TALs-Education/NanoBalancer/README.md

# NanoBalancer
Nano Balancer Robot, based on Arduino nano esp32, Arduino nano motor shield
