TALs-Education/NanoBalancer/NanoBalancer BOM - NanoBalancer BOM V02.pdf

NanoBalancer BOM V02 | https://a360.co/4zzZkpO
Parts | Units | Price [nis] | Total 10 for units Link | Comments | Link2
M3x6 | 4 | 0.8 | 40 https://www.4project.co.il/product/screw-m3x6mm-galvanized 4 Arduino mkr motor shield bolts
M3 plastic disc | 4 | 0.1 | 40 https://www.4project.co.il/product/washer-m3-nylon spacer to protect circuit
M3x10 | 10 | 4.563 | 100 https://www.digikey.co.il/he/products/detail/io-audio-technologies/IO-M3X10-M3HN-100/13949728 V shape bolts: 2 - battery holder 6 bumper holders, spare
M4x20 | 2 | 1.904 | 20 https://www.4project.co.il/product/screw-m4x20mm-button-head-25pack Beam Bolts
XT30 Female | 1 | 6.3 | 10 https://www.4project.co.il/product/181184 XT30 Safe Plug
Micro usb cable | 1 | 25.8 | 10 https://www.4project.co.il/product/microb-usb-cable-1.8m micro usb to usb cable for arduino
ABX00041 Motor carrier | 1 | 362.15 | 10 https://www.digikey.co.il/en/products/detail/arduino/ABX00041/16645360 arduino nano33 iot motor carrier
Arduino Nano ESP32 | 1 | 105.2 | 10 https://www.4project.co.il/product/arduino-nano-esp32 arduino nano33 ESP32
18650 battery holder | 1 | 5.2 | 10 https://www.4project.co.il/product/1x18650-battery-holder battery holder 18650
Li-Ion 3.7V/2500mAh | 1 | 34.7 | 10 https://www.4project.co.il/product/18650-lg-he4-battery-3.7v-2500mah 18650 battery
3d Printer filament | 0.2 | 34.45 | 2 https://www.4project.co.il/product/petg-1.75mm-red-filament Petg 3d filament blue red green
3d Printer filament flexible | 0.2 | 24.38 | 2 https://www.4project.co.il/product/tpu-flex-1.75mm-red-filament flex filament for bumpers
micro motor 1:30 hpcb 12v | 2 | 121.9 | 20 https://www.4project.co.il/product/micro-metal-gearmotor-hpcb-12v-1100rpm-encoder-shaft 4P-6977 / POL-3049
Micro motor extended holder | 1 | 25.8 | 10 https://www.4project.co.il/product/micro-motor-holder-extended-white 4P-504 / POL-1089
magnetic encoder | 1 | 37.3 | 10 https://www.4project.co.il/product/207352 4P-207352 / POL-4761
jst-sh encoder wires | 2 | 5.6 | 20 https://www.4project.co.il/product/6pin-female-jst-sh-style-cable-12cm 4P-207349 / POL-4762
wheels 40mm | 1 | 25.8 | 10 https://www.4project.co.il/product/4823 4P-4823 / POL-1453

## Optional - Maybe required

lithium charger | 1 | 57.4 | 10 https://www.4project.co.il/product/sparkfun-lipo-charger-plus 4P-395500 / SF-PRT-15217
xt30 charger wires | 1 | 11.4 | 10 https://www.4project.co.il/product/xt30-female-awg16-300mm 4P-560542 / SC-3800-0002-0300
JST-PH 2-pin | 1 | 3.9 | 10 https://www.4project.co.il/product/jst-ph-2pin-connector-with-wires battery connector
usb C cable | 1 | 31.9 | 10 https://www.4project.co.il/product/usb-c-cable-90cm Battery charger wire
USB meter | 1 | 48.9 | 10 https://www.4project.co.il/product/848782 USB voltage current meter
| Total Price | 975.447 | 9754.47
