TALs-Education/NanoBalancer/NanoBalancer_Stabilization_Parameters.xlsx

Sheet: Summary
NanoBalancer — Stabilisation Parameters Summary
All values are live formulas linked to Inputs (edit blue cells there). Model state: d276 = 8 mm, sliced print masses, 2× 18650 in parallel.
Parameter | Symbol / key | Value | Unit | Source / formula notes
Mass & geometry
Total mass | S_M | 426.4 | g
Body mass (excl. wheels) | S_mb | 420.0 | g
Body CoM height above axle l | S_l | 135.3 | mm
CoM fore/aft offset from axle | S_z | -0.004 | mm | ≈ 0 → balance point is vertical
Wheel radius | S_r | 20.0 | mm
Wheel track | S_track | 84.3 | mm
Moments of inertia
Body pitch inertia about axle | S_Ibax | 107315.1525 | g·cm²
Body pitch inertia about CoM | S_Ib | 30458.9594 | g·cm²
Wheel-side inertia (2 wheels + reflected rotors) | S_Iw | 69.8 | g·cm² | Rotor part is an ASSUMPTION
Yaw inertia | S_Iyaw | 3832.822522 | g·cm²
Motor & driver
Max torque per motor (500 mA limit) | S_Tlim | 0.244 | kg·cm
Max total torque | S_Ttot | 48.0 | mN·m
Fraction of motor stall torque usable | S_Tfrac | 62.68656716% | –
Max ground speed (no load) | S_vmax | 2.30 | m/s
Full torque available up to | S_vcorner | 0.86 | m/s
Balancing
Unstable open-loop pole (wheels free) | S_p | 12.69 | rad/s
Fall time constant | S_tfall | 78.77685906 | ms
Recommended min. control-loop rate | S_floop | 100 | Hz
Torque authority τ_max / (m_b·g·l) | S_ratio | 0.086 | –
Max tilt holdable with wheels blocked | S_hold | 4.9 | deg
Max recoverable lean (small-angle, at low speed) | S_thss | 36.5 | deg
Max steady acceleration | S_acc | 5.40 | m/s²
Power
Peak battery current (both motors at limit) | S_Ibat | 4.12 | A
Estimated runtime | S_run | 5.9 | h | ASSUMED average power

Sheet: Inputs
NanoBalancer — Inputs (blue = editable input)
Parameter | Symbol / key | Value | Unit | Source / formula notes
Physical constants
Gravity | g | 9.81 | m/s² | Standard gravity
Whole robot (from Fusion 360, wheels included)
Total mass | M_tot | 0.4264 | kg | Fusion 360 physical properties (VeryHigh accuracy), file NanoBalancer_V01 v3, d276 = 8 mm, sliced print masses
CoM height above axle (Y) | y_com_tot | 0.13324 | m | Fusion 360 physical properties (VeryHigh accuracy), file NanoBalancer_V01 v3, d276 = 8 mm, sliced print masses. Axle is the world X axis (y = 0, z = 0).
CoM fore/aft offset from axle (Z) | z_com_tot | -0.000004 | m | Fusion 360 physical properties (VeryHigh accuracy), file NanoBalancer_V01 v3, d276 = 8 mm, sliced print masses. Tuned to ~0 by d276 = 8 mm.
Ixx about axle (pitch), whole robot | Ixx_tot | 0.01073314845 | kg·m² | Fusion 360 physical properties (VeryHigh accuracy), file NanoBalancer_V01 v3, d276 = 8 mm, sliced print masses. Moments are about the world origin, which lies on the axle.
Iyy about vertical axis through axle centre (yaw) | Iyy_tot | 0.0003832822522 | kg·m² | Fusion 360 physical properties (VeryHigh accuracy), file NanoBalancer_V01 v3, d276 = 8 mm, sliced print masses
Izz about fore/aft axis (roll) | Izz_tot | 0.0108836442 | kg·m² | Fusion 360 physical properties (VeryHigh accuracy), file NanoBalancer_V01 v3, d276 = 8 mm, sliced print masses
Wheels (Pololu 40x7 mm, per wheel, from Fusion 360)
Wheel mass (each) | m_w1 | 0.00320 | kg | Fusion 360 physical properties (VeryHigh accuracy), file NanoBalancer_V01 v3, d276 = 8 mm, sliced print masses. Datasheet-based 3.2 g assigned.
Wheel spin inertia about axle (each) | Iw_spin1 | 8.166023149e-07 | kg·m² | Fusion 360 physical properties (VeryHigh accuracy), file NanoBalancer_V01 v3, d276 = 8 mm, sliced print masses (Ixx of wheel body).
Wheel radius | r_w | 0.020 | m | Pololu 40 mm wheel (model bbox 40.0 mm).
Wheel track (centre to centre) | track | 0.0843 | m | Fusion 360 physical properties (VeryHigh accuracy), file NanoBalancer_V01 v3, d276 = 8 mm, sliced print masses (wheel centroids).
Gearmotor: Pololu #3049, 30:1 Micro Metal Gearmotor HPCB 12 V, extended shaft (per motor)
Rated / spec voltage | V_rated | 12.0 | V | Pololu #3049 specs.
Gear ratio | N | 29.86 | – | Pololu #3049 specs (29.86:1).
No-load speed @ 12 V (output) | rpm_nl | 1100 | rpm | Pololu #3049 specs (typ. ±20%).
No-load current @ 12 V | I_nl | 0.080 | A | Pololu #3049 specs (typ. ±50%).
Stall current @ 12 V | I_stall | 0.750 | A | Pololu #3049 specs (theoretical extrapolation).
Stall torque @ 12 V (output) | T_stall_kgcm | 0.39 | kg·cm | Pololu #3049 specs (theoretical extrapolation).
Motor rotor inertia (motor side) — ASSUMPTION | J_rotor | 3e-09 | kg·m² | ASSUMPTION: ~0.03 g·cm², typical for 10 mm coreless/brushed micro motors. Not published by Pololu. Reflected to the wheel ×N² — verify by spin-down test.
Motor driver: Arduino Nano Motor Carrier ABX00041 (4× MP6522)
Motor driver output voltage (boosted) | V_drv | 12.0 | V | ABX00041 datasheet: motor driver output voltage 12 V.
Max output current per motor driver | I_lim | 0.500 | A | ABX00041 datasheet: 500 mA per driver. MP6522 chip itself is 3.2 A peak; board limit governs.
Max battery input (power terminals) | V_bat_max | 4.0 | V | ABX00041 datasheet: max 4 V (1S Li-ion).
Boost converter efficiency — ASSUMPTION | eta_boost | 85% | – | ASSUMPTION: typical small boost converter 3.7→12 V.
Battery: 2× LG HE4 18650 in parallel (1S2P)
Cells in parallel | n_cells | 2 | – | Model has two holders; carrier accepts 1S only → parallel.
Cell nominal voltage | V_cell | 3.60 | V | LG HE4 nominal 3.6 V.
Cell capacity | C_cell | 2.50 | Ah | BOM: Li-Ion 3.7V/2500mAh (LG HE4).
Cell max continuous discharge | I_cell_max | 20 | A | LG HE4 datasheet: 20 A continuous.
Electronics power (ESP32 + carrier + IMU) — ASSUMPTION | P_elec | 0.60 | W | ASSUMPTION: Nano ESP32 with WiFi idle ~0.4 W + carrier/IMU ~0.2 W.
Average motor electrical power while balancing — ASSUMPTION | P_mot_avg | 2.00 | W | ASSUMPTION for runtime estimate; measure with the USB meter / current sense.
Sensor location
IMU (BNO055 on carrier) height above axle — APPROX. | y_imu | 0.0625 | m | Carrier centre from rough model (exact chip position on PCB not modelled).
Control design guidance
Loop-rate multiple of unstable pole frequency | k_loop | 30 | – | Rule of thumb: sample ≥ 20–40× the open-loop unstable pole frequency.
Legend: blue = hard-coded input (edit here) · black = formula · green = link from another sheet · yellow fill = key / uncertain inputs worth checking.

Sheet: Inertia
Mass & Moment of Inertia
Parameter | Symbol / key | Value | Unit | Source / formula notes
Wheel side (both wheels + reflected rotor)
Mass of both wheels | m_w | 0.00640 | kg | 2 × wheel mass
Spin inertia, both wheels | Iw_wheels | 1.63320463e-06 | kg·m² | 2 × wheel Ixx
Reflected rotor inertia, both motors | Iw_rotor | 5.3497176e-06 | kg·m² | J_rotor × N² × 2 (ASSUMED rotor inertia)
Total wheel-side inertia Iw | Iw | 6.98292223e-06 | kg·m² | Used in dynamics
Body (everything except wheels; motor stators/gearboxes are part of body)
Body mass m_b | m_b | 0.4200 | kg | Total − wheels
Body CoM height above axle l | l | 0.13527 | m | Wheels' CoM lies on axle → l = M·y / m_b
Body CoM fore/aft offset | z_b | -0.000004 | m
Body pitch inertia about axle | Ib_axle | 0.01073151525 | kg·m² | Ixx(total) − wheel Ixx (wheels are on the axle)
Body pitch inertia about own CoM Ib | Ib | 0.00304589594 | kg·m² | Parallel-axis theorem
Body radius of gyration about CoM | r_gyr | 0.0852 | m
Yaw (turning)
Yaw inertia about vertical axis (whole robot) | I_yaw | 0.0003832822522 | kg·m² | From Fusion (includes wheels)
Same values in convenient units
Body pitch inertia about axle | Ib_axle_gcm2 | 107315.1525 | g·cm² | 1 kg·m² = 1e7 g·cm²
Body pitch inertia about CoM | Ib_gcm2 | 30458.9594 | g·cm²
Wheel-side inertia (both, incl. rotor) | Iw_gcm2 | 69.8 | g·cm²
Yaw inertia | Iyaw_gcm2 | 3832.822522 | g·cm²
Body CoM height above axle | l_mm | 135.3 | mm

Sheet: Motor & Driver
Motor & Driver Limits (per motor unless stated)
Parameter | Symbol / key | Value | Unit | Source / formula notes
Derived motor constants (output shaft, per motor, linear DC-motor model)
Stall torque @ 12 V | T_stall | 0.03825 | N·m | 1 kg·cm = 0.0980665 N·m
No-load speed @ 12 V | w_nl | 115.19 | rad/s
Terminal resistance (est.) | R_m | 16.00 | Ω | R ≈ V / I_stall
Torque constant at output (incl. gearbox losses) | Kt | 0.05708 | N·m/A | Kt = T_stall / (I_stall − I_nl)
Back-EMF constant at output | Ke | 0.09306 | V·s/rad | Ke = (V − I_nl·R) / ω_nl
Implied gearbox efficiency Kt/Ke | eta_gb | 61.33904325% | – | Ratio of torque to speed constants
Limits with the Nano Motor Carrier (12 V, 500 mA per channel)
Max torque per motor at current limit | T_lim | 0.02398 | N·m | T = Kt·(I_lim − I_nl); the 500 mA limit is below the 750 mA stall current
Max torque per motor at current limit | T_lim_kgcm | 0.244 | kg·cm
Max total torque (both motors) | T_tot | 0.04795 | N·m | τ_max used in dynamics
Fraction of stall torque available | T_frac | 62.68656716% | –
Output speed where current limit stops binding | w_corner | 42.98 | rad/s | Above this speed, back-EMF limits current below I_lim
… same in rpm | rpm_corner | 410.4477612 | rpm
Max output speed @ driver voltage (no load) | w_max | 115.19 | rad/s
Max ground speed (no load) | v_max | 2.30 | m/s
Ground speed at full-torque corner | v_corner | 0.86 | m/s | Full torque available below this speed
Max traction force (both wheels) | F_max | 2.398 | N | τ_max / r
Power & battery
Max motor electrical power (both, at limit) | P_mot_max | 12.0 | W | 2 × 12 V × 0.5 A
Battery current at max motor power | I_bat_peak | 4.12 | A | Through boost converter
… per cell | I_bat_cell | 2.06 | A | Compare with cell rating
Pack energy | E_bat | 18.0 | Wh
Estimated runtime while balancing | t_run | 5.9 | h | Uses ASSUMED average powers

Sheet: Dynamics
Balancing Dynamics
Parameter | Symbol / key | Value | Unit | Source / formula notes
Linearised wheeled inverted pendulum (planar). θ = body tilt (+ forward), φ = wheel angle, τ = total motor torque on wheels (reaction on body)
a = Ib + m_b·l² | dyn_a | 0.01073151524 | kg·m² | Equations: a·θ'' + b·φ'' = m_b·g·l·θ − τ ; b·θ'' + c·φ'' = τ
b = m_b·r·l | dyn_b | 0.001136354352 | kg·m²
c = Iw + (m_b + m_w)·r² | dyn_c | 0.0001775590062 | kg·m²
D = a·c − b² | dyn_D | 6.141759677e-07 | kg²·m⁴
Gravity torque coefficient m_b·g·l | mgl | 0.5574 | N·m/rad
Open-loop behaviour
Unstable pole, wheels free | p_free | 12.69 | rad/s | p = √(c·m_b·g·l / D)
Unstable pole, wheels locked (pivot on axle) | p_lock | 7.21 | rad/s | Simple pendulum about the axle
Fall time constant 1/p (wheels free) | tau_fall | 0.079 | s | Tilt grows ×e every τ_fall
Time to double a tilt error | t_double | 0.055 | s
Unstable pole frequency | f_pole | 2.02 | Hz
Recommended minimum control-loop rate | f_loop | 100 | Hz | ≥ k × pole frequency (min 100 Hz)
Torque authority with the 500 mA limit
Gravity torque at 1° tilt | T_grav_1deg | 0.00973 | N·m
τ_max / (m_b·g·l) | ratio_tau | 0.086 | – | >0 required; higher = more authority
Max tilt holdable with wheels blocked (e.g. against a wall) | theta_hold | 4.9 | deg | asin(τ_max / m_b·g·l)
Max steady lean while accelerating (wheels free) | theta_ss | 36.5 | deg | θ = τ·(1 + b/c)/(m_b·g·l) — max tilt that full torque can still counter (small-angle)
Max ground acceleration from upright | acc_max | 18.53 | m/s² | ẍ = r·(a+b)/D·τ at θ = 0
Steady acceleration at max torque (body leaning) | acc_steady | 5.40 | m/s² | Whole robot accelerating with body at θ_ss
Time to reach full-torque corner speed | t_to_vcorner | 0.16 | s | After this, available torque falls with speed
Yaw
Max yaw acceleration (opposite torques) | yaw_acc_max | 263.6 | rad/s² | Ignores wheel inertia; shares torque budget with balancing

Sheet: State Space
Linear State-Space Model (for LQR / pole placement)
Parameter | Symbol / key | Value | Unit | Source / formula notes
Torque input u = τ (N·m, both motors). State x = [θ, θ', x, x'] with x = r·φ (wheel travel)
A(2,1) ∂θ''/∂θ | A21 | 161.140 | 1/s²
A(4,1) ∂x''/∂θ | A41 | -20.625 | m/s²
B(2) ∂θ''/∂τ | B2 | -2139.31 | 1/(kg·m²)
B(4) ∂x''/∂τ | B4 | 386.46 | 1/(kg·m)
Voltage input u = V (both motors same command, |V| ≤ 12 V; current limit 0.5 A not modelled)
Torque per volt (both motors) 2·Kt/R | k1 | 0.00714 | N·m/V | τ = k1·V − k2·(φ' − θ')
Back-EMF damping (both motors) 2·Kt·Ke/R | k2 | 0.00066 | N·m·s/rad
A(2,1) | Av21 | 161.140 | 1/s²
A(2,2) | Av22 | -1.421 | 1/s
A(2,4) | Av24 | 71.029 | 1/(m·s)
A(4,1) | Av41 | -20.625 | m/s²
A(4,2) | Av42 | 0.257 | m/s
A(4,4) | Av44 | -12.831 | 1/s
B(2) | Bv2 | -15.265 | 1/(V·s²)
B(4) | Bv4 | 2.758 | m/(V·s²)
Voltage-input model, matrix form x' = A·x + B·u
A | θ | θ' | x | x' | B
θ' | 0.000 | 1.000 | 0.000 | 0.000 | 0.000
θ'' | 161.140 | -1.421 | 0.000 | 71.029 | -15.265
x' | 0.000 | 0.000 | 0.000 | 1.000 | 0.000
x'' | -20.625 | 0.257 | 0.000 | -12.831 | 2.758

Sheet: Torque-Speed
Torque available vs wheel speed (per motor, 12 V, 500 mA limit)
Wheel speed (rpm) | Speed (rad/s) | Ground speed (m/s) | Current (A) | Torque per motor (N·m) | Torque per motor (kg·cm) | Total torque (N·m) | Max steady lean (deg)
0 | 0.0 | 0.00 | 0.500 | 0.02398 | 0.244 | 0.04795 | 36.5
50 | 5.2 | 0.10 | 0.500 | 0.02398 | 0.244 | 0.04795 | 36.5
100 | 10.5 | 0.21 | 0.500 | 0.02398 | 0.244 | 0.04795 | 36.5
150 | 15.7 | 0.31 | 0.500 | 0.02398 | 0.244 | 0.04795 | 36.5
200 | 20.9 | 0.42 | 0.500 | 0.02398 | 0.244 | 0.04795 | 36.5
250 | 26.2 | 0.52 | 0.500 | 0.02398 | 0.244 | 0.04795 | 36.5
300 | 31.4 | 0.63 | 0.500 | 0.02398 | 0.244 | 0.04795 | 36.5
350 | 36.7 | 0.73 | 0.500 | 0.02398 | 0.244 | 0.04795 | 36.5
400 | 41.9 | 0.84 | 0.500 | 0.02398 | 0.244 | 0.04795 | 36.5
450 | 47.1 | 0.94 | 0.476 | 0.02260 | 0.230 | 0.04520 | 34.4
500 | 52.4 | 1.05 | 0.445 | 0.02086 | 0.213 | 0.04172 | 31.7
550 | 57.6 | 1.15 | 0.415 | 0.01912 | 0.195 | 0.03825 | 29.1
600 | 62.8 | 1.26 | 0.385 | 0.01738 | 0.177 | 0.03477 | 26.4
650 | 68.1 | 1.36 | 0.354 | 0.01565 | 0.160 | 0.03129 | 23.8
700 | 73.3 | 1.47 | 0.324 | 0.01391 | 0.142 | 0.02782 | 21.2
750 | 78.5 | 1.57 | 0.293 | 0.01217 | 0.124 | 0.02434 | 18.5
800 | 83.8 | 1.68 | 0.263 | 0.01043 | 0.106 | 0.02086 | 15.9
850 | 89.0 | 1.78 | 0.232 | 0.00869 | 0.089 | 0.01738 | 13.2
900 | 94.2 | 1.88 | 0.202 | 0.00695 | 0.071 | 0.01391 | 10.6
950 | 99.5 | 1.99 | 0.171 | 0.00522 | 0.053 | 0.01043 | 7.9
1000 | 104.7 | 2.09 | 0.141 | 0.00348 | 0.035 | 0.00695 | 5.3
1050 | 110.0 | 2.20 | 0.110 | 0.00174 | 0.018 | 0.00348 | 2.6
1100 | 115.2 | 2.30 | 0.080 | 0.00000 | 0.000 | 0.00000 | 0.0
Rows step 50 rpm (edit column A). Linear motor model: I = (V − Ke·ω)/R clipped to I_lim; τ = Kt·(I − I_nl).

Sheet: Mass Budget
Mass budget used in Fusion 360 (positions in mm; Y up from axle, Z fore/aft)
Group | Item | Mass (g) | X (mm) | Y (mm) | Z (mm) | Note
Printed | Main body (PETG) | 95.90 | 0 | 102.1 | 0 | Bambu sliced (H2C 0.4, 0.20mm Std, 35% grid); estimate was 93.24 g
Printed | Hanging beam (PETG) | 7.33 | 0 | 242.5 | 0 | Bambu sliced (H2C 0.4, 0.20mm Std, 35% grid); estimate was 7.14 g
Printed | Bumper 1 (TPU AMS) | 56.68 | 36.7 | 178.5 | 0 | Bambu sliced (H2C 0.4, 0.20mm Std, 35% grid); estimate was 58.48 g
Printed | Bumper 2 (TPU AMS) | 56.68 | -36.7 | 178.5 | 0 | Bambu sliced (H2C 0.4, 0.20mm Std, 35% grid); estimate was 58.48 g
Printed | BatteryClips (TPU AMS) | 2.92 | 0 | 162.9 | 14.8 | Bambu sliced (H2C 0.4, 0.20mm Std, 35% grid); estimate was 3.08 g
Drive | Gearmotor 30:1 HPCB L | 9.50 | -28.1 | 0 | 0
Drive | Wheel 40x7 L | 3.20 | -42.1 | 0 | 0
Drive | Motor bracket ext. L | 0.80 | -27 | 1.5 | 0.1
Drive | Magnetic encoder L | 0.50 | -9.6 | 3.3 | 0
Wiring | JST-SH encoder cable L | 2.00 | -15 | 15 | 3 | z shifted -1mm for Extrude32 side2=2.5mm
Battery | 18650 LG HE4 L | 46.00 | -16 | 164.3 | 7.5 | z shifted -1mm for Extrude32 side2=2.5mm
Battery | 18650 holder (bought) L | 8.00 | -16.1 | 162.5 | 3.5 | z shifted -1mm for Extrude32 side2=2.5mm
Drive | Gearmotor 30:1 HPCB R | 9.50 | 28.1 | 0 | 0
Drive | Wheel 40x7 R | 3.20 | 42.1 | 0 | 0
Drive | Motor bracket ext. R | 0.80 | 27 | 1.5 | 0.1
Drive | Magnetic encoder R | 0.50 | 9.6 | 3.3 | 0
Wiring | JST-SH encoder cable R | 2.00 | 15 | 15 | 3 | z shifted -1mm for Extrude32 side2=2.5mm
Battery | 18650 LG HE4 R | 46.00 | 16 | 164.3 | 7.5 | z shifted -1mm for Extrude32 side2=2.5mm
Battery | 18650 holder (bought) R | 8.00 | 16.1 | 162.5 | 3.5 | z shifted -1mm for Extrude32 side2=2.5mm
Electronics | Carrier PCB 80x50x1.6 (modeled) | 12.00 | 0 | 62.5 | 0.8 | rough body
Electronics | Carrier components block 44x74x5 (modeled) | 20.00 | 0 | 62.5 | 4.1 | rough body
Electronics | Carrier female headers (modeled) | 3.00 | 0 | 62.5 | 5.85 | rough body
Electronics | Nano ESP32 18x45x3.2 (modeled) | 7.00 | 0 | 62.5 | 11.7 | rough body
Fasteners | M3x6 x4 + nylon washers | 2.20 | 0 | 62.5 | 2.5 | z shifted -1mm for Extrude32 side2=2.5mm
Fasteners | M3x10+nut x2 (battery clamp) | 2.40 | 0 | 163 | 16 | z shifted -1mm for Extrude32 side2=2.5mm
Fasteners | M3x10+nut x3 bumper L | 3.60 | -33 | 120 | 0
Fasteners | M3x10+nut x3 bumper R | 3.60 | 33 | 120 | 0
Fasteners | M4x20 + nut x2 (beam) | 7.00 | 0 | 242.5 | 0
Wiring | XT30 + battery/power wiring | 6.00 | 0 | 120 | 4 | z shifted -1mm for Extrude32 side2=2.5mm
 | Sum of listed items | 426.3 |  | 132.5 |  | Mass-weighted Y (listed z values for tray items are at d276 = 2.5 mm; see note)
 | Fusion total (authoritative) | 426.4 |  | 133.2
Note: carrier + Nano are modelled as rough bodies (42 g); printed parts use Bambu-sliced masses. Small differences vs Fusion come from rounding and the modelled bodies.

Sheet: Sources
Sources & assumptions
Item | Reference
Fusion 360 model | NanoBalancer_V01 v3 (TALs-Education / NanoBalancer), d276 = 8 mm; physical properties at VeryHigh accuracy.
Pololu #3049 gearmotor specs | https://www.pololu.com/product/3049/specs
Arduino Nano Motor Carrier ABX00041 datasheet | https://mm.digikey.com/Volume0/opasdata/d220001/medias/docus/5444/ABX00041.pdf (MP6522 ×4, 12 V output, 500 mA per driver, 1S input max 4 V)
MP6522 driver | https://www.monolithicpower.com/jp/products/motor-drivers-and-motor-controllers/mp6522.html (5.4–35 V, 3.2 A peak — board limit 500 mA governs)
Bambu TPU for AMS TDS | https://cdn.shopify.com/s/files/1/1339/4265/files/Bambu_TPU_for_AMS_Technical_Data_Sheet.pdf (1.26 g/cm³)
Bambu Studio slicing | Bambu Studio 2.05 CLI, Bambu Lab H2C 0.4 nozzle, 0.20mm Standard @BBL H2C, 35% grid infill, 2 walls, no brim/support.
BOM | NanoBalancer BOM V02 (PDF in project folder).
Assumptions | Rotor inertia, boost efficiency, electronics and average motor power are estimates — marked ASSUMPTION on the Inputs sheet.
