TALs-Education/NanoBalancer/3dModel/MainBody_PETG.stl

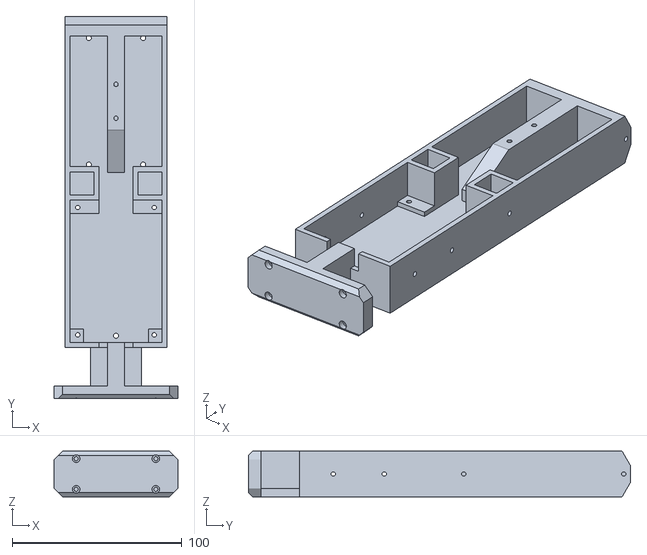
[picture p14: CAD file, 2026-11-08]
3dModel/MainBody_PETG.stl
73.0 x 225.0 x 27.0
