TALs-Education/NanoBalancer/3dModel/BatteryClips_TPU.stl

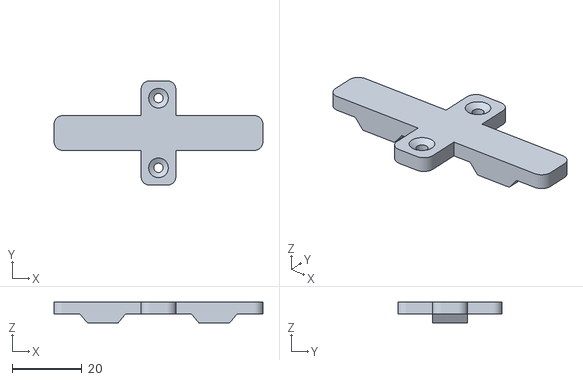
[picture p15: CAD file, 2026-11-08]
3dModel/BatteryClips_TPU.stl
60.0 x 30.0 x 6.00
