TALs-Education/NanoBalancer/3dModel/sliced/bum1.3mf

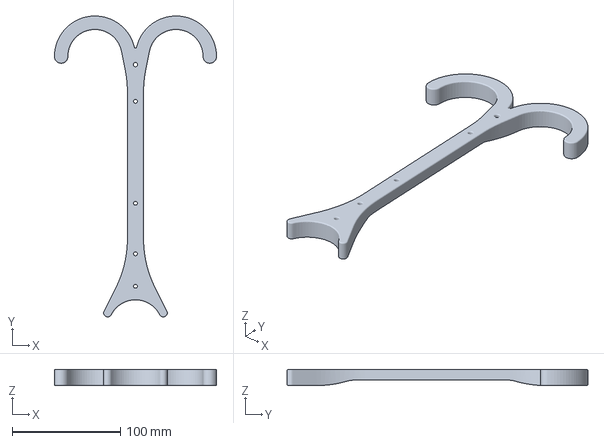
[picture p16: CAD file, 2026-11-08]
3dModel/sliced/bum1.3mf
150.0 x 278.3 x 15.0 mm
