TALs-Education/NanoBalancer/3dModel/sliced/beam.3mf

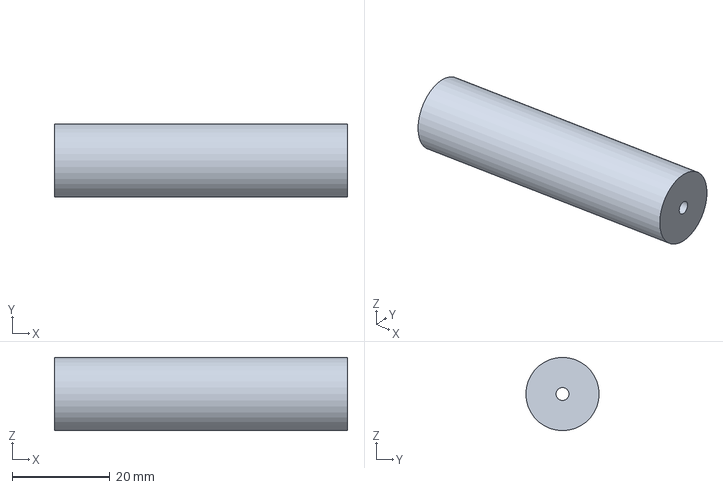
[picture p17: CAD file, 2026-11-08]
3dModel/sliced/beam.3mf
60.0 x 15.0 x 15.0 mm
