TALs-Education/NanoBalancer/3dModel/sliced/clips.3mf

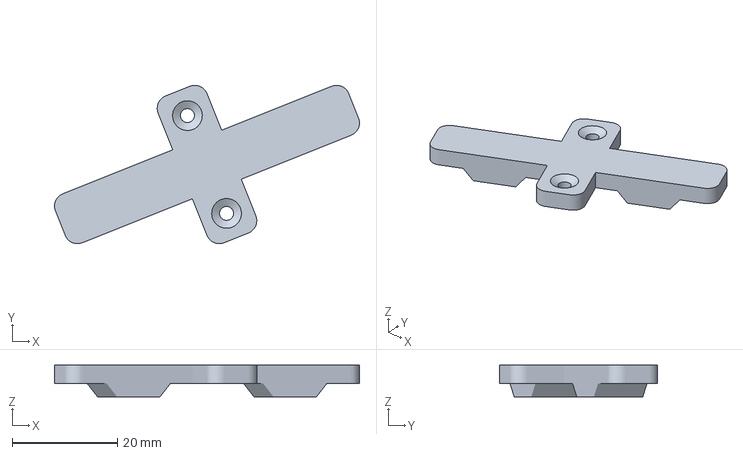
[picture p18: CAD file, 2026-11-08]
3dModel/sliced/clips.3mf
57.9 x 30.1 x 6.00 mm
