TALs-Education/NanoBalancer/3dModel/Hanger_PETG_notInCoM.stl

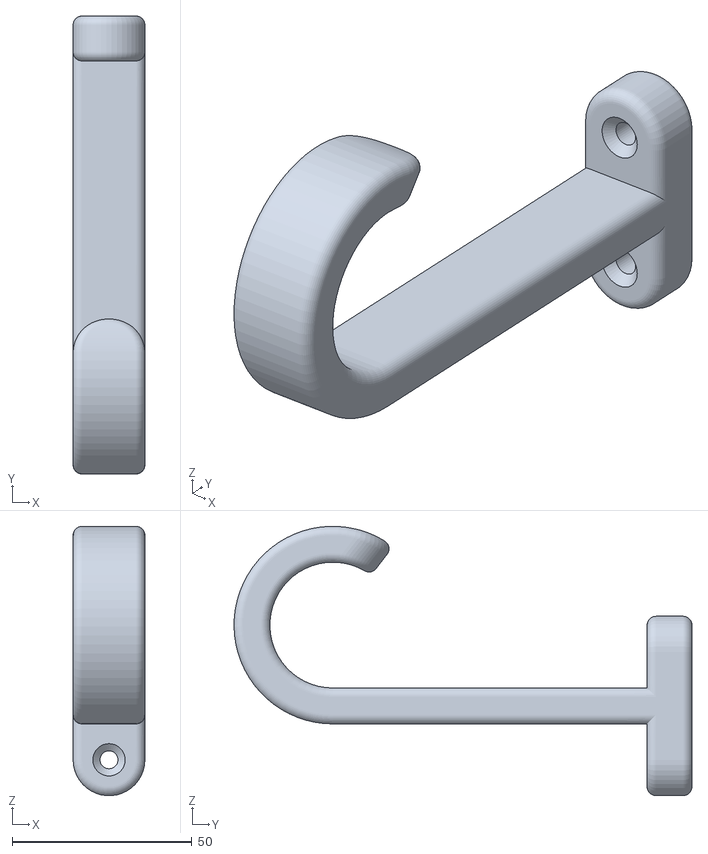
[picture p19: CAD file, 2026-11-08]
3dModel/Hanger_PETG_notInCoM.stl
20.0 x 127.5 x 75.0
