TALs-Education/NanoBalancer/(list of files, cad)

Other CAD files:
3dModel/sliced/main.3mf
3dModel/Bumper2_TPU.stl
3dModel/HangingBeam_PETG.stl
3dModel/sliced/bum2.3mf
3dModel/Bumper1_TPU.stl
